irahulone/sprayer_system/v2_largim_and_katie/archives/LargimZhuta_Capstone.pdf

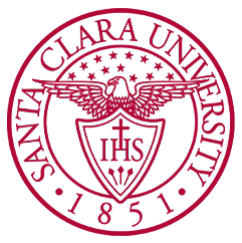
[picture p1: figure]

School Of Engineering
Mechanical Engineering Department

Date: Jun 03, 2024

I HEREBY RECOMMEND THAT THE CAPSTONE PREPARED UNDER MY SUPERVISION BY

Largim Zhuta

ENTITLED

Variable Rate Adaptive Sprayer System

BE ACCEPTED IN PARTIAL FULFILLMENT OF THE REQUIREMENTS FOR THE DEGREE

OF

MASTER OF SCIENCE IN MECHANICAL ENGINEERING IN MECHANICAL ENGINEERING DEPARTMENT

Variable Rate Adaptive Sprayer System

Capstone submitted in partial fulfillment of the requirements for the degree of

Master of Science in Mechanical Engineering

Largim Zhuta

Master Of Science In Mechanical Engineering in the School of Engineering at
Santa Clara University, Jun 2024

Santa Clara, California

Acknowledgments

I would like to express deep gratitude to my advisors and supervisors, Dr. Christopher Kitts & Dr. Manoj Sharma. They’re guidance, wisdom, and motivation to explore, discover, and engineer what is yet to be was inspiring. It was a genuine privilege and pleasure of mine to have had the opportunity to work under them and their guidance.
This marks six years that I have attended Santa Clara University. I would especially like to acknowledge all the professors I have had throughout my time here, especially Dr. Hohyun Lee, who has played a tremendous role in my academic and personal journey.
I am forever grateful to my family; They have sacrificed so much for me to have the opportunities I have had; The success I have achieved is not solely mine, but rather it is ours, collectively.
Lastly, but certainly not least, my close friends. I thank you for the companionship you have all shown me. The support you openly gave when the responsibilities I carried felt too heavy to bear will never be forgotten.
Largim Zhuta

Santa Clara University
June 15th, 2024

iii

Dedicated To,

My Family, Friends, Mentors and loved ones who have been in my corner through every step of the way.

iv

Abstract

The current labour and resource shortage is driving the agriculture industry towards adopting more humane, sustainable and efficient means of production. Robotics and automation is one of the solutions to address those challenges. Precision spraying, in particular, is a technique that relies on a precise targeted metered delivery of a desired fluid. In this paper we have designed a sprayer system as a module for our in-house modular rover that can administer a fluid in a controlled manner. It offers a discrete left and right independent spray control, each withing the rage of 120 - 400 L/h. Tests conducted in the field shows the performance within 0.1 - 4.8 % of the commanded value. Furthermore, we layout the framework for a high level sprayer-rover interface controller to intelligently adapt and command the desired flow rates
Keywords: Variable Rate Sprayer, Precision Spraying, Precision Agriculture

v

## Contents

Acknowledgments | iii
Abstract | v
Contents | v
List of Figures | vi
List of Tables | vii
1 Introduction | 1
2 System Overview | 4
3 Control and Validation | 8
4 Conclusion & Future Work | 17
A Appendix | 20

vi

## List of Figures

2.1 AgBot Rover and Sprayer System in the Field | 5
2.2 Sprayer system overview | 5
2.3 Sprayer System Plumbing and Instrumentation Diagram | 6
2.4 Sprayer and the rover system integration | 7
3.1 Control Block diagram representation of Sprayer System | 9
3.2 Sprayer system left-bank open loop response at different valve positions. . . 10 3.3 Sprayer system open-loop nozzle flow rate left and right bank time varying response to a ramp (pump power) input at a constant valve position of 80%. 11 3.4 Step-Input response to desired flow rate inputs of 131 l/h for both left and
right bank | 13
3.5 Step-Input response to desired flow rate inputs of 360 l/h for the left bank
and 210 l/h for the right bank | 14
3.6 Step-Input response to desired flow rate inputs of 210 l/h for the left bank
and 360 l/h for the right bank | 14
3.7 Multi-zone time response | 15
A.1 | | 29
A.2 | | 30
A.3 | | 31
A.4 | | 32
A.5 | | 33
A.6 | | 34
A.7 | | 35

vii

## List of Tables

3.1 Zone-level flow rates (L/h) | 16

viii

## Chapter 1

## Introduction

Agricultural industries across the globe play vital roles when it comes to the nourishment and survival of humankind. Feeding an ever-growing global population places everincreasing demands on an already stressed industry: one affected by labor shortages, climate change, human labor rights concerns, stricter food safety regulations, and a desire for more sustainable farming practices (reducing food waste) [1]. The continually expanding application of robotics and automation technologies within the agricultural sector has created a viable solution to the aforementioned challenges; the subsequent practice is referred to as precision agriculture. Robotics and automation technologies integration within agriculture can lead to more efficient, cost-effective, sustainable, and humane farming practices [2].
The application of pesticides, herbicides, fungicides, and/or other “-cides” is a significant process in agriculture pertaining to the management of pests, diseases, and weeds, allowing for increased yields. Efficient application of the aforementioned agrochemicals increases yield, but can cause environmental risks in the event of over application or double coverage of a given region. Additionally, over application can pose health risks to humans as well [3]. Over application incurs greater costs on the farmers as well. Precision spraying is one domain within precision agriculture which is adopting automation technologies to improve efficacy and minimize waste via various precision spraying techniques and methodologies.
Variable rate automated sprayer systems consist of two major processes: automated 1

1.1 Ethical Implications and Considerations | 2

vision-based weed detection and automated targeted-spraying; it is an area of current research and development efforts [4], [5], [6], [7]. The aforementioned techniques have been implemented in large-scale productions fields, displaying the viability of the technology [8]. Commercial systems, such as the One Smart Spray from Bosch [9] employs real-time weed detection via high-resolution cameras to identify weeds; it then applies herbicide in the locations needed, reducing costs for the growers while also reducing the amount of herbicide needed.
Different vehicle types exist within the realm of precision spraying: unmanned aerial vehicles (UAV) [10], ground-level fluid lines, and self-propelled ground vehicles. The scope of the presented work is to create a modular precision sprayer system which is able to be integrated to an existing rover, developed by Santa Clara University’s Robotics Systems Laboratory; the rover is referred to as the Agbot [11]. The motivation behind the creation of the sprayer is system is to elevate the functional capabilities of the Agbot and similar robotic/rover platforms which serve as a support system for various precision agricultural operations. [12].

### 1.1 Ethical Implications and Considerations

Robots have shown their utility in agricultural field operations [13]. Capable of operating in environments that are deemed harsh and difficult for humans, as well as being able to meet the demands of strenuous labor requirements and challenging work patterns, robots and robotic devices are capable of supplanting human laborers. The pace of the transition will likely be a gradual process, creating a transition phase in which humans and robots will co-exist in the field operations [14]. Another considerable challenge the agriculture industry faces is a significant labor shortage; the consequences of which includes crops going unharvested, leading to food waste, and higher labor costs [15]. Utilizing robotic and automation technology can supplement and provide the existing labor and its capabilities, but with added efficiency at a more cost-effective rate. Despite all the benefits robotics and automation is poised to provide, we acknowledge that there are some ethical considerations. Like most transitions and adoptions of new technologies, there are positive and

1.1 Ethical Implications and Considerations | 3

negative impacts. Supplanting human labors with robotics, especially in precision spraying application, reduces humans’ exposure to spraying chemicals, decreasing the health risks of the farmers. Additionally, robotics and automation are able to perform repetitive, heavelabor tasks, alleviating human laborers from the chore. The tradeoff is that human laborers will be displaced.

## Chapter 2

## System Overview

The system overview is split in four different subsection. The first three subsections provides an overview of the mechanical, electrical and software architecture of the sprayer module fol- lowed by a description on the specifics of how the sprayer module is integrated within the rover system in mechanical, electrical and software sense. Figure A.7

### 2.1 Mechanical Subsystem

The mechanical sub-system is comprised of two sub-assemblies: the frame structure and the plumbing. The frame structure serves as the backbone of the sprayer system. It is assembled from aluminum T-slotted rails. Virtually all of the subsystems are mounted onto the frame structure The plumbing sub system includes (1) Fluid Reservoir, (2) positivedisplacement pumps, silicone vacuum seal tubing, and (4) modular Nozzle Units (NUs) as shown in Figure 1.
The NUs are comprised of (3) key components: a servo valve, a flow sensor, and a nozzle. NU 1, NU 2, and the Left Pump constitute the left bank of the Sprayer System. NU 3, NU 4, and the Right Pump make up the right bank. Each bank operates independently of the other: they only share the same reservoir tank. This is shown in plumbing schematic.

4

2.2 Electrical Subsystem | 5

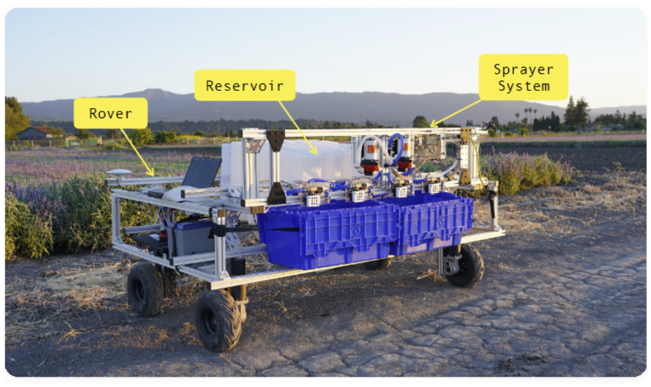
[picture p2: figure]

Figure 2.1 – AgBot Rover and Sprayer System in the Field

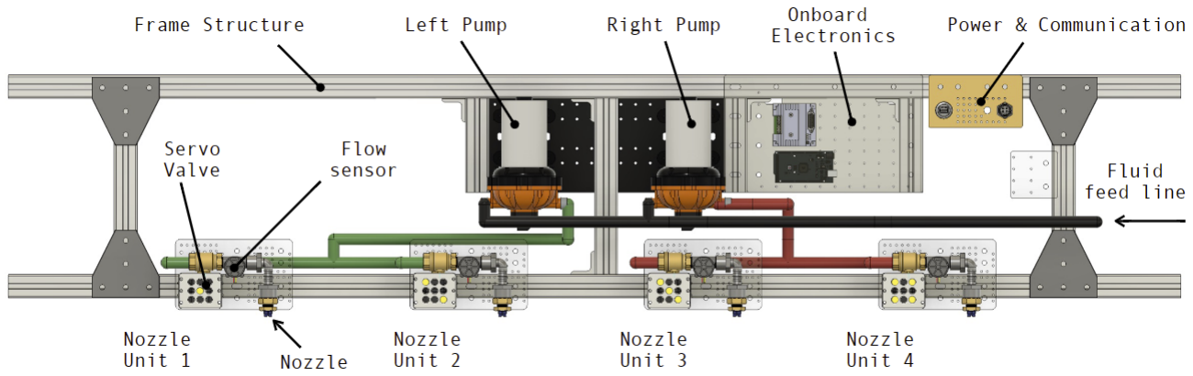
[picture p3: figure]

Figure 2.2 – Sprayer system overview.

### 2.2 Electrical Subsystem

The key electrical subsystem comprises of the pump, servo controlled valve, and flow rate sensor. The two pumps are controlled by a (RoboteQ) motor controller. An Arduino Mega 2560 is the micro-controller of choice which controls the respective pump power, servovalve, and receives the instantaneous flow rate information from all four nozzle units.
An onboard computer (Jetson Nano) is dedicated to allow the information exchange between the sprayer system and the rover system. The entire sprayer system is designed to operate at 12 VDC which is provided by the rover.

2.3 Software Subsystem | 6

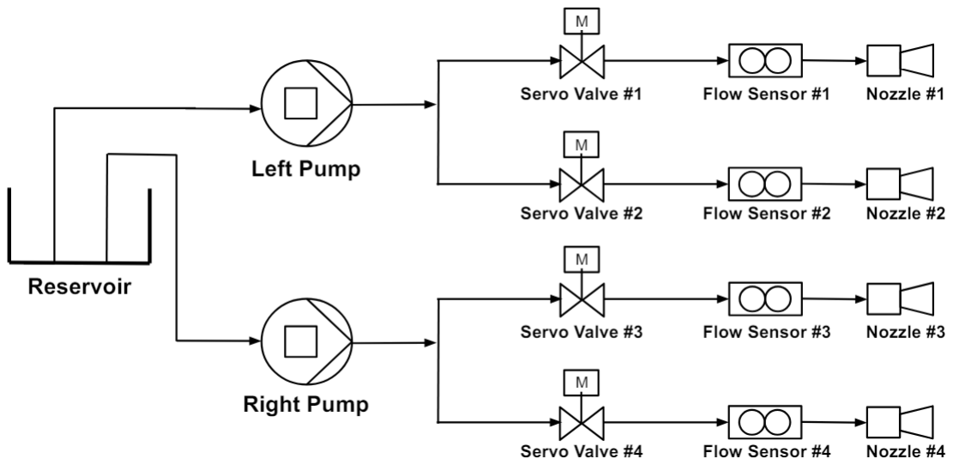
[picture p4: figure]

Figure 2.3 – Sprayer System Plumbing and Instrumentation Diagram

### 2.3 Software Subsystem

Three functional systems exist within the software subsystem: data acquisition, data display, and the controller. Real-time flow rate data and pump power is recorded for each flow sensor and each pump. It is stored in ROS 1 bags via an additional Arduino Mega 2560. The aforementioned real-time data is displayed in a serial monitor within the Arduino IDE. An error-based Proportional Integral (PI) controller with a feed-forward term is implemented for the sprayer system; desired flow rate data and measured flow rate data is used to calculate the error.

### 2.4 Sprayer-Rover Integration

In a bus and payload analogy, the sprayer system is the payload which relies on the rover (the bus) to receive the necessary support needed for the mission. Both, the rover and the sprayer system are constructed using a standard size T-slotted aluminium bar. This allows for a convenient mechanical integration using off-the-shelf brackets. The sprayer receives the electrical power from the rover. The rover system uses the Robot Operating System (ROS) middleware as the main control framework [11]. Figure 2.4 shows the overall sprayer-rover integrated system. The sprayer controller has access to the position sensors, speed, vision system and other onboard data to compute desired flow rate information.

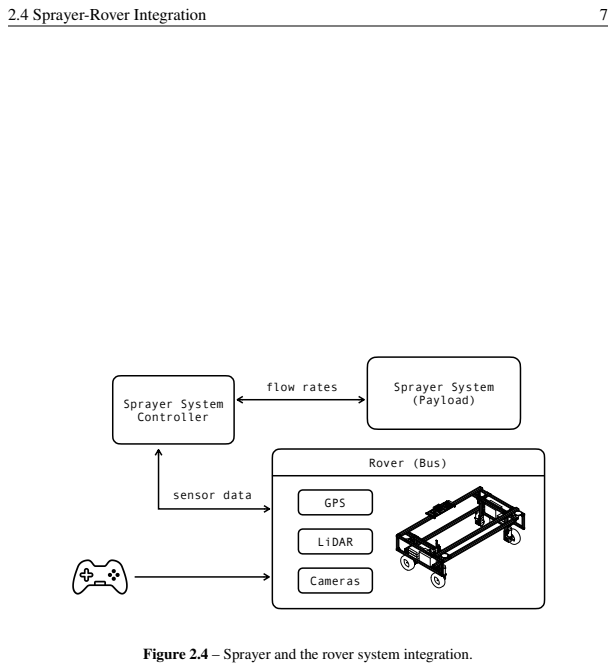
[picture p5: page 15]
2.4 Sprayer-Rover Integration; GPS; Cameras; Rover (Bus); Sprayer System; (Payload); Controller; LiDAR; flow rates; sensor data

Figure 2.4 – Sprayer and the rover system integration.

## Chapter 3

## Control and Validation

While Proportional-Integral-Derivative (PID) control methodology is a very established and robust control scheme, we opted for a Proportional-Integral (PI) Control with a mapping function. The mapping function serves as a pseudo feed-forward term which incorporates information regarding the open-loop behavior of the system.

### 3.1 Control System Design

The control system design is a Proportional-Integral (PI) controller with the addition of a mapping function. The controller scheme inputs are desired flow rates for the left and right bank, ¯ql and ¯qr

, respectively. Separate and unique mapping functions Ml and Mr are used to convert the desired flow rates into a pump powers for each bank. The desired flow rate signals are then summed with the measured flow rates, ql and qr creating resultant error signals, el and er for the two banks. The error signal is then fed into a Proportional-Integral controller. The output of the left and right bank controllers yield a pump power value, pl and pr

.The pump power values are then summed at each summing junction and fed into the their respective pumps. The pumps then produce a flow rate, which is fed through the servo valves, flow sensor, and nozzle; this ultimately outputs the measured flow rate.

8

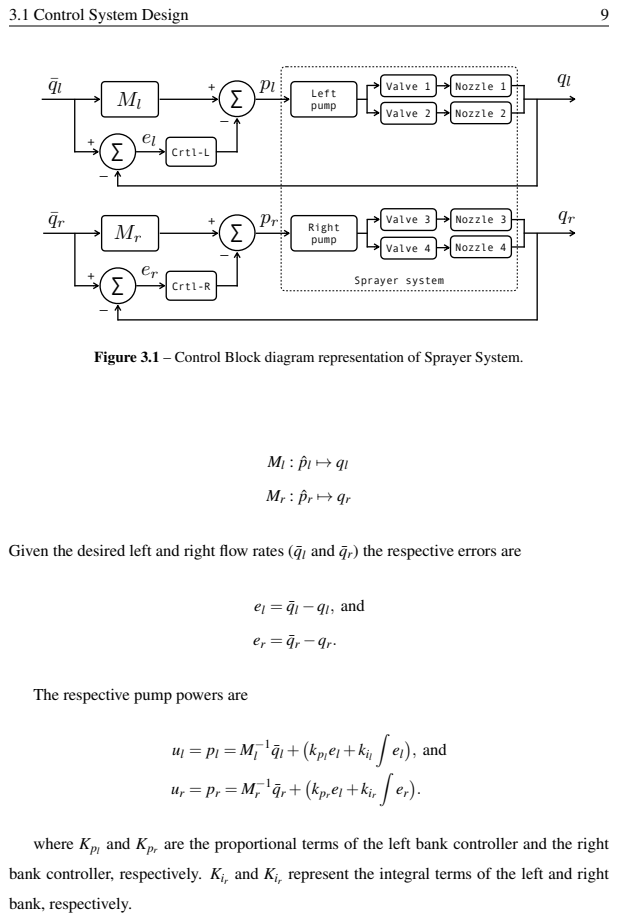
[picture p6: page 17]
3.1 Control System Design; Left; pump; Nozzle 1; Nozzle 2; Crtl-L; Right; Nozzle 3; Nozzle 4; Crtl-R; Sprayer system; Valve 1; Valve 2; Valve 3; Valve 4; : ˆpl; : ˆpr; , and; kpl; el +kil;  , and;  kpr; el +kir; and Kpr; and Kir

Figure 3.1 – Control Block diagram representation of Sprayer System.

Given the desired left and right flow rates ( ¯ql and ¯qr) the respective errors are

The respective pump powers are

where Kpl
bank controller, respectively. Kir
bank, respectively.

are the proportional terms of the left bank controller and the right

represent the integral terms of the left and right

3.1 Control System Design | 10

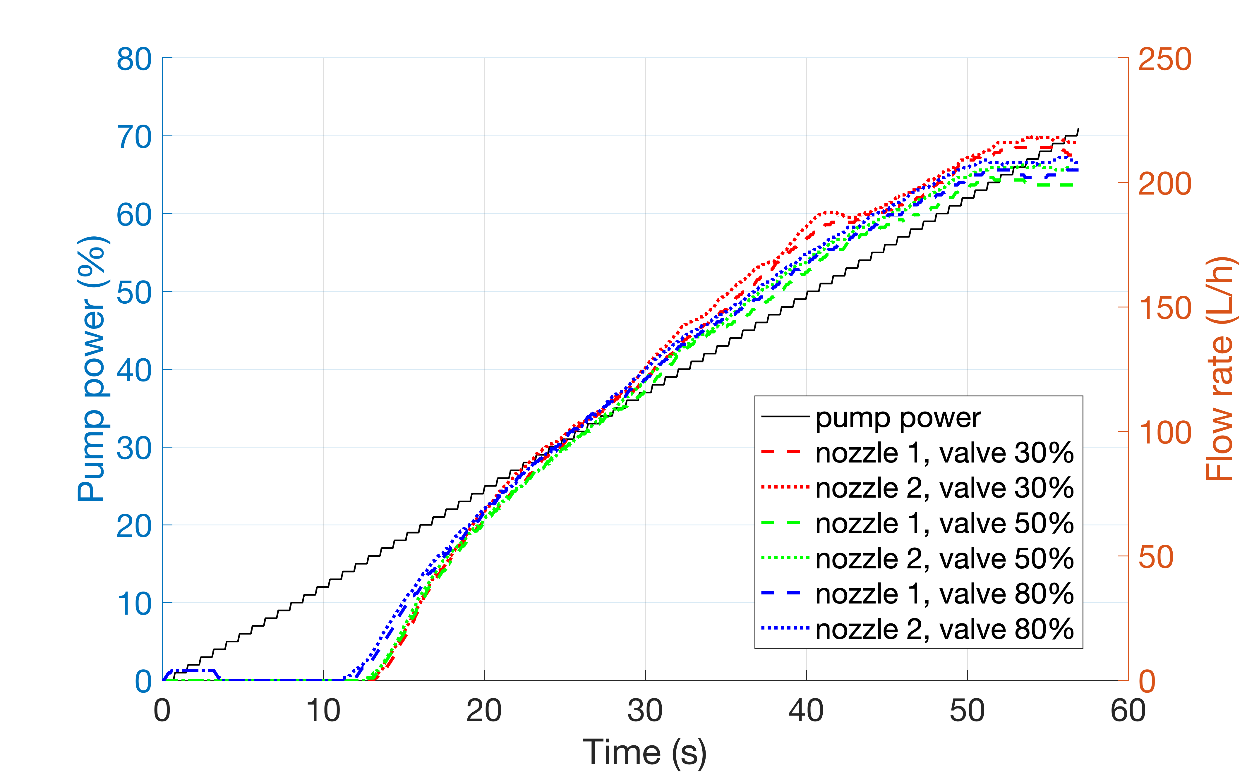
[picture p7: figure]

Figure 3.2 – Sprayer system left-bank open loop response at different valve positions.

### 3.1.1 Mapping Function

The relationship between valve positions, pump power, and flow rate was investigated. An open-loop system test was ran for a ramp-input of pump powers ranging from 0% to 70%. Three of these open-loop trials were ran, each at a constant valve position. In Figure 3.2, the open-loop response of the Left Bank can be seen. It is discovered that for a given pump power, the valve position has virtually no effect on the flow rate of the system – barring the valve is completely closed. Pump power is the only variable that affected the flow rate. Utilizing the open-loop characteristics of the system, distinct mapping functions are created for each bank, correlating pump power to a specific flow rate. The plot was generated by using a ramp-input at valve positions of 80% open. Figure 3.3 displays the open loop behavior of each bank. It can be seen that despite being the same pump, the open-loop characteristics of each of the banks differs slightly; for the same pump power, the Right Bank is able to dispense for fluid than the Left Bank. This could be due to differing lengths of tubing needing to be used or that the Right Bank pump was new compared to the Left Bank pump.

3.1 Control System Design | 11

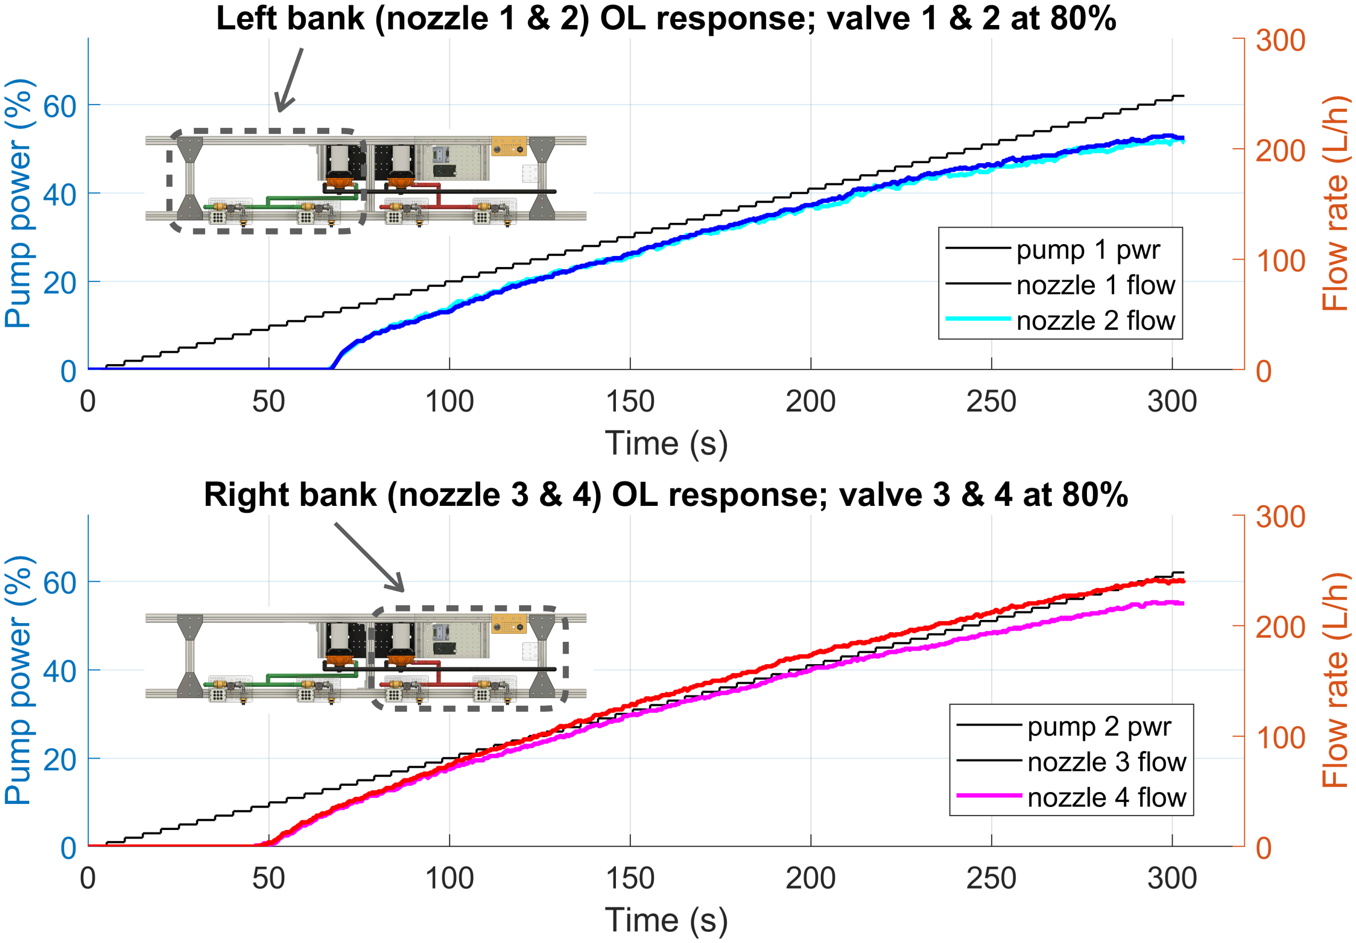
[picture p8: figure]

Figure 3.3 – Sprayer system open-loop nozzle flow rate left and right bank time varying response to a ramp (pump power) input at a constant valve position of 80%.

3.2 Testing and Results | 12

### 3.2 Testing and Results

The sprayer is a closed loop system, delivering a desired flow rate using an error-based controller. The performance of the system is highly dependent on the accuracy of each flow sensor. System performance verification was performed concurrently with system performance testing.
System performance testing was solely based on the collecting flow sensor data given an array of desired inputs. The verification portion involved collecting the dispensed water via collection bins and noting the total time elapsed during the trial. Average flow rates for each bank were then calculated by dividing the total volume of water collected in the bins by the total time of the trial. Note that this method of verification is prone to human error in measurement and reaction time, resolution error in the analog measuring tools, evaporation due to wind, etc.
The testing occurred on a nearby farm in an environment that would likely resemble the rover and sprayer system’s natural area of operation: one with external factors such as wind, dust, and uneven, rocky terrain. The testing occurred while the rover was in motion at a speed within the range of 0.2m/s to 0.4m/s. In order to determine the performance of the system, time-response plots are captured for arbitrary step-inputs.

### 3.2.1 Left Bank Flow: 131 L/h & Right Bank Flow: 131 L/h

In Fig. 3.4, the desired flow is set to 131 L/h for both banks. It takes the left and right bank approximately 8.5 seconds to settle given a 15% error band. The reason behind the relatively large error band is because the system is not able to fully settle below a 15% error due to limitations in the sensors’ resolution and computation.
The recorded flow rate data appears to take on discrete values. In the steady state region of Fig.3.4, the recorded data takes on one of the following values: 113 L/h , 122 L/h, 131 L/h, a 140 L/h. This indicates that the resolution of the sensor is roughly 9L/h per bit. Given this finding, performing Root Mean Squared (RMS) calculations on the entirety of data provides greater insight over the steady state behavior.
The RMS value for the left bank in Fig.3.4 is 125.3 L/h, and the RMS value for the right

3.2 Testing and Results | 13

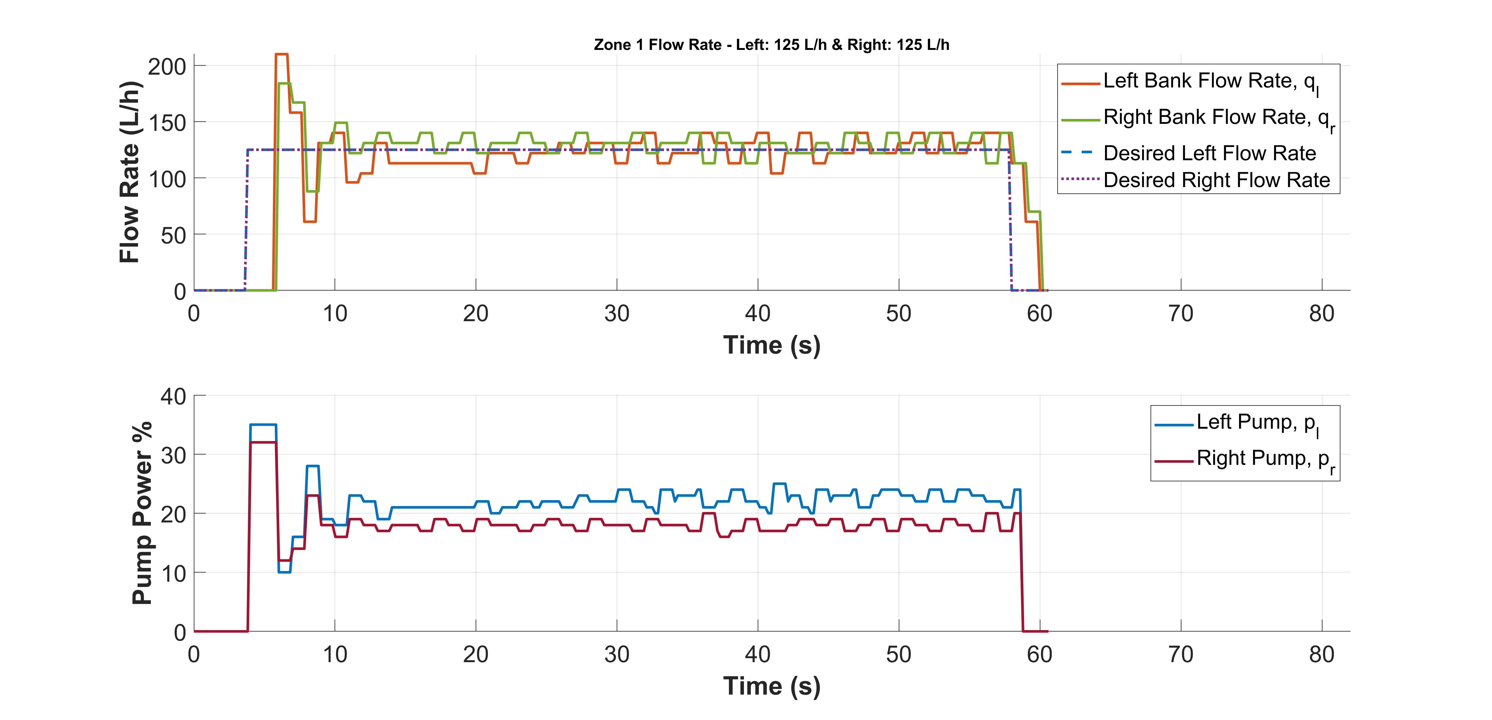
[picture p9: figure]

Figure 3.4 – Step-Input response to desired flow rate inputs of 131 l/h for both left and right bank.

bank is 130.8 L/h. The RMS value is compared against the desired flow rate of 131L/h for both banks; it equates to an error of 4.8% and 0.1% for the left and right bank, respectively. From the verification test, the calculated flow rates are determined to be 133.4 L/h and 131.7 L/h for the left and right banks, respectively. This amounts to an error of 1.8% and 0.5% between the desired flow rates and averaged flow rates of the system.

### 3.2.2 Left Bank Flow: 360 L/h & Right Bank Flow: 210 L/h

In Fig.3.5, the settling time for the system is shorter, and the error band is smaller; for a 10% error band, the settling time is approximately 2.5 seconds for both banks. The RMS values are 353.4L/h and 211.0L/h for the left and right bank, respectively. It equates to errors of 1.8% and −0.4%.
For the verification test performed in Fig. 3.5, the desired flow rates are 360L/h and 210L/h, respectively. The average flow rates are calculated to be 356.0L/h and 211.8L/h for the left and right bank respectively: yielding absolute errors of 1.1% and 0.8%

3.2 Testing and Results | 14

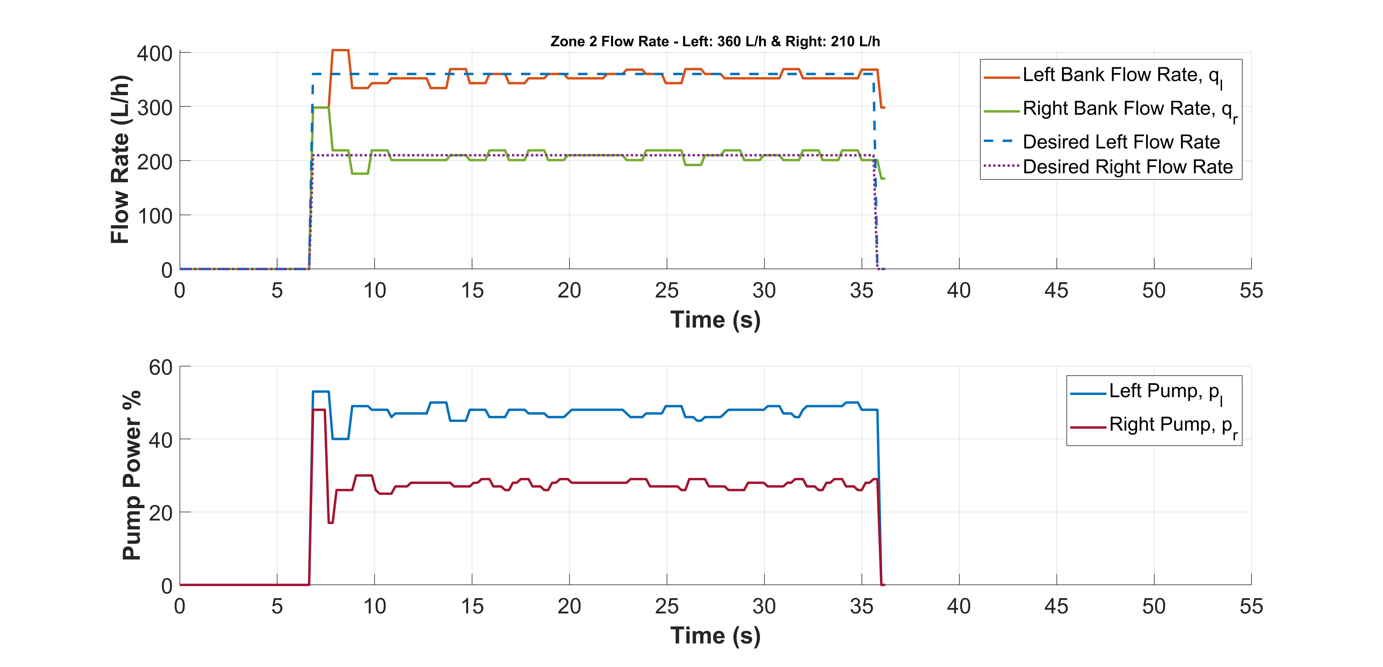
[picture p10: figure]

Figure 3.5 – Step-Input response to desired flow rate inputs of 360 l/h for the left bank and 210 l/h for the right bank.

### 3.2.3 Left Bank Flow: 210 L/h & Right Bank Flow: 360 L/h

In Fig.3.6, a similar result can be seen when the desired flow rates for the left and right banks are swapped with the other. The 10% settling time is also approximately 2.5 seconds for both banks. The RMS values are 208.0L/h and 353.4L/h for the left and right bank, respectively. This yields errors of 0.9% for the left bank and 1.8% for right bank.

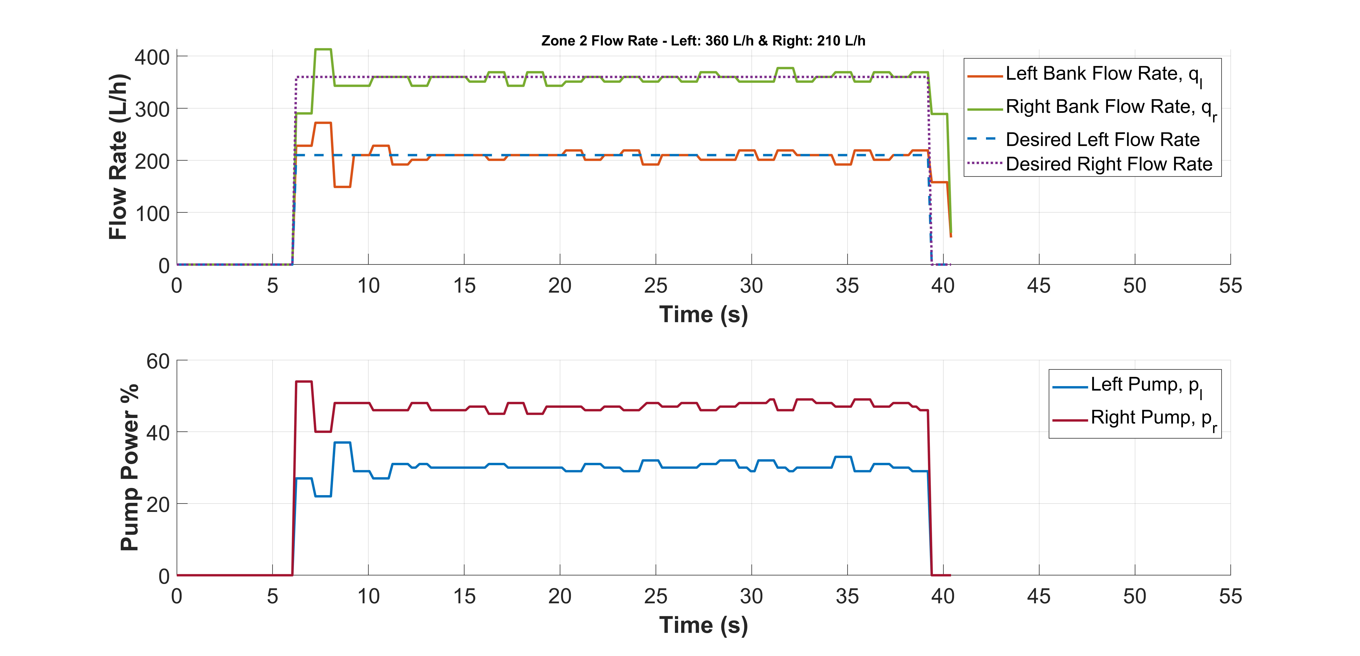
[picture p11: figure]

Figure 3.6 – Step-Input response to desired flow rate inputs of 210 l/h for the left bank and 360 l/h for the right bank.

3.2 Testing and Results | 15

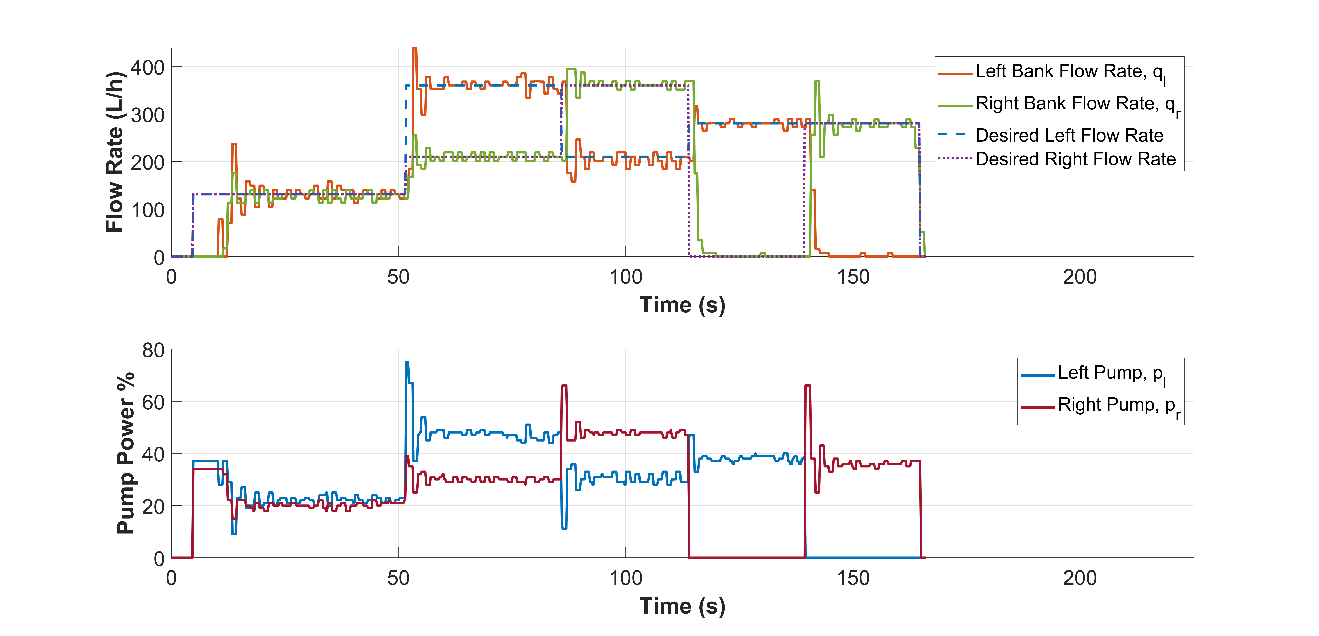
[picture p12: figure]

Figure 3.7 – Multi-zone time response.

In Fig. 3.6 the desired flow rates for the left and right bank are 210L/h and 360L/h, respectively. The average flow rates for the left and right bank were 217.5L/h and 352.3L/h, amounting to errors of 3.6% and 2.1%.

### 3.2.4 Continuous Variable Flow Rate Test Run

Figure 3.7 shows a performance test for a multi-zone trial. Five arbitrary zones were created, each with different desired flow rates. The multi-zone trial was performed while the rover was moving at speeds between 0.2m/s and 0.4m/s.The zones were advanced via button toggling through the main rover controller; this displays the potential ability to control the sprayer through an outer, rover control loop which could include GPS data, LIDAR, or vision data as shown in Fig. 2.4
The performance of the multi-zone run is consistent with what was seen in the step-input responses. The desired flow rate, sensor reading, and actual measured volume/calculated flow rates are tabulated in 3.1. In terms of system performance, the settling time between zone transitions is between 2 to 3 seconds; it remains consistent with the individual step inputs. One notable exception can be seen in the plot during the initial power up; the reason behind the larger than expected settling time of the first zone is due to the pumps needing time to prime the system. Left at rest for a sufficient amount of time, the water

3.2 Testing and Results | 16

Table 3.1 – Zone-level flow rates (L/h)
Zone | Left-bank flow | Right-bank flow
Desired Flow | Sensor | Actual Flow | Desired Flow | Sensor | Actual Flow
1 2 3 | 131 360.0 210.0 | 125.3 353.4 208.0 | 133.4 356.0 217.5 | 131.0 210.0 360.0 | 130.8 211.0 353.4 | 131.7 211.8 352.3

drains downward and out of pumps, thus causing a larger initial settling time.
The results from the system performance tests indicate that the system is able to administer the desired flow rate within a 4.8% RMS error margin. (i.e. RMS flow sensor reading compared to the desired flow rate). The system performance verification shows that the administered flow rate is accurate to within a 3.6% error margin (i.e. the physical amount of water collected over a finite time compared to the desired flow rate)

## Chapter 4

## Conclusion & Future Work

### 4.1 Conclusion

In this paper We have designed and constructed a modular sprayer attachment for the existing Agbot Rover which provides the necessary infrastructure for the mission. The sprayer system’s closed-loop proportional-integral controller with a mapping function has been shown to be capable of administering the desired flow rate within an error margin between 0.1% and 4.8%. Furthermore it has displayed the ability to toggle between various different flow rates within a 2 − 3 second settling time between each transition. Lastly, a framework has been created between the sprayer and rover which will allow for the exchange of information between the two. The main purpose of the framework is to develop prescription-based controller.

### 4.2 Future Work

The next logical step of the Sprayer System and Agbot Rover evolution would be to incorporate GPS data from the Agbot Rover to control the desired flow rate based on the location of the Rover in field. Further future work could be focused on incorporating the Rover’s velocity in the sprayer system controller in order to provide a flow rate metric of volume sprayed per area; this is the industry standard with regards to spraying operations within the agriculture industry.
17

## List of References

[1] J. P. Vasconez, G. A. Kantor, and F. A. Auat Cheein, “Human–robot interaction in agriculture: A survey and current challenges,” Biosystems Engineering, vol. 179, pp. 35 – 48, 2019. [Online]. Available: http://www.sciencedirect.com/science/article/pii/S1537511017309625 (http://www.sciencedirect.com/science/article/pii/S1537511017309625)
[2] S. S. H. Hajjaj and K. S. M. Sahari, “Review of agriculture robotics: Practicality and feasibility,” in 2016 IEEE International Symposium on Robotics and Intelligent Sensors (IRIS), 2016, pp. 194–198.
[3] F. Ahmad and M. Sultan, “Advancements of spraying technology in agriculture,” in Technology in Agriculture, 2021, pp. 33–43.
[4] Y. Guan, D. Chen, K. He, Y. Liu, and L. Li, “Review on research and application of variable rate spray in agriculture,” in 2015 IEEE 10th Conference on Industrial Electronics and Applications (ICIEA), 2015, pp. 1575–1580.
[5] R. Berenstein and Y. Edan, “Automatic adjustable spraying device for site-specific agricultural application,” IEEE Transactions on Automation Science and Engineering, vol. 15, no. 2, pp. 641–650, 2018.
[6] R. Aravind, M. Daman, and B. S. Kariyappa, “Design and development of automatic weed detection and smart herbicide sprayer robot,” in 2015 IEEE Recent Advances in Intelligent Computational Systems (RAICS), 2015, pp. 257–261.
[7] A. Khan, F. Nasir, M. Tufail, M. Haris, M. T. Khan, and Z. Dong, “Design and implementation of model predictive control (mpc) based pressure regulation system for

18

List of References | 19

a precision agricultural sprayer,” in 2023 International Conference on Robotics and Automation in Industry (ICRAI), 2023, pp. 1–6.

[8] G. H. do Nascimento, F. Weber, G. Almeida, F. Terra, and P. L. J. Drews, “A perception system for an autonomous pesticide boom sprayer,” in 2019 Latin American Robotics Symposium (LARS), 2019 Brazilian Symposium on Robotics (SBR) and 2019 Workshop on Robotics in Education (WRE), 2019, pp. 86–91.
[9] B. Blakely. (2023) One smart spray. [Online]. Available: https://www.businesswire.com/news/home/20230912991567/en/ (https://www.businesswire.com/news/home/20230912991567/en/)
[10] Y. Guo, C. Liu, and M. Coombes, “Spraying coverage path planning for agriculture unmanned aerial vehicles,” in 2021 26th International Conference on Automation and Computing (ICAC), 2021, pp. 1–6.
[11] Modular and Reconfigurable Multiple Drive-Unit Based Rover - Design and Control, ser. ASME International Mechanical Engineering Congress and Exposition, vol. Volume 2: Advanced Design and Information Technologies, 10 2023. [Online]. Available: https://doi.org/10.1115/IMECE2023-112155
[12] S. J. LeVoir, P. A. Farley, T. Sun, and C. Xu, “High-accuracy adaptive low-cost location sensing subsystems for autonomous rover in precision agriculture,” IEEE Open Journal of Industry Applications, vol. 1, pp. 74–94, 2020.
[13] R. Bogue, “Robots poised to revolutionise agriculture,” vol. 43, no. 5, 2016.
[14] F. A. Cheein, D. Herrera, J. Gimenez, R. Carelli, M. Torres-Torriti, J. R. Rosell-Polo,
A. Escolà, and J. Arnó, “Human-robot interaction in precision agriculture: Sharing the workspace with service units,” in 2015 IEEE International Conference on Industrial Technology (ICIT), 2015, pp. 289–295.
[15] F. Yandun Narvaez, G. Reina, M. Torres-Torriti, G. Kantor, and F. A. Cheein, “A survey of ranging and imaging techniques for precision agriculture phenotyping,” IEEE/ASME Transactions on Mechatronics, vol. 22, no. 6, pp. 2428–2439, 2017.

## Appendix A

## Appendix

This Capstone Paper is predominantely based on a conference paper written for an ASME Conference. The Capstone paper goes into further detail regarding the controller used for the sprayer system.

A.1 Code Listings

The listings package allows you to include code listings or other formatted text with some parsing to make them more readable than simply calling \input{} on the code file.

Listing A.1 – ARDUINO Sprayer System Controller Code label ✞ | ☎

/ / Hardware − Arduino Mega 2560

i n t u_p1 = 0 ;
i n t u_p2 = 0 ;

f l o a t pump_pwr [ 2 ] = { 0 . 0 , 0 . 0 } ;
f l o a t v a l v e _ p o s [ 4 ] = { 0 . 0 , 0 . 0 , 0 . 0 , 0 . 0 } ;
f l o a t f l o w _ r a t e _ u f [ 4 ] = { 0 . 0 , 0 . 0 , 0 . 0 , 0 . 0 } ; f l o a t f l o w _ r a t e [ 4 ] = { 0 . 0 , 0 . 0 , 0 . 0 , 0 . 0 } ;
f l o a t d e s _ f l o w _ r a t e [ 4 ] = { 0 . 0 , 0 . 0 , 0 . 0 , 0 . 0 } ;

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

A.1 Code Listings | 21

i n t f l o w _ s 3 _ a r [ window_size ] ;

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

un si gned l o n g c u r r e n t T i m e ;

un si gned l o n g cloopTime ;

un si gned l o n g cloopTime2 ;

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

v oi d s e t _ v a l v e ( i n t i = 0 , i n t x = 0) {

A.1 Code Listings | 22

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

i f ( x < 0) x = 0 ;
e l s e i f ( x >= 100) x = 10 0;
i n t v = map ( x , 0 , 100 , 0 , 2 5 5 ) ;

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

i n t max_per = 6 0 ;
i f ( v a l < 0) v a l = 0 ;
e l s e i f ( v a l > max_per ) v a l = max_per ; i n t v = map ( val , 0 , 100 , 0 , 1 0 0 0 ) ;

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

i f ( ch ==2)
{
S e r i a l 3 . p r i n t ( " !G 2 " ) ;

A.1 Code Listings | 23

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

A.1 Code Listings | 24

r e t u r n a ;
}

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

r e t u r n a ;
}

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

r e t u r n a ;
}

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

r e t u r n a ;
}

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

A.1 Code Listings | 25

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

d e b u g _ d i s p ( ) ;
}

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

}

}

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

}

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

A.1 Code Listings | 27

i f ( x == 1)
{
v a l v e _ p o s [ 0 ] = y ; }
i f ( x == 2)
{
v a l v e _ p o s [ 1 ] = y ; }
i f ( x == 3)
{
v a l v e _ p o s [ 2 ] = y ; }
i f ( x == 4)
{
v a l v e _ p o s [ 3 ] = y ; }
pump_pwr [ 0 ] = z ;
pump_pwr [ 1 ] = z ;
* /

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

i f ( u_p1 > 60) u_p1= 6 0 ; i f ( u_p1 < 0) u_p1= 0 ;

i f ( u_p2 > 60) u_p2= 6 0 ; i f ( u_p2 < 0) u_p2= 0 ;

pump_pwr [ 0 ] = u_p1 ;

A.2 Conference Paper | 28

pump_pwr [ 1 ] = u_p2 ;

}

✝ | ✆

A.2 Conference Paper

The remainder of this section is intentionally left blank.

A.2 Conference Paper | 29

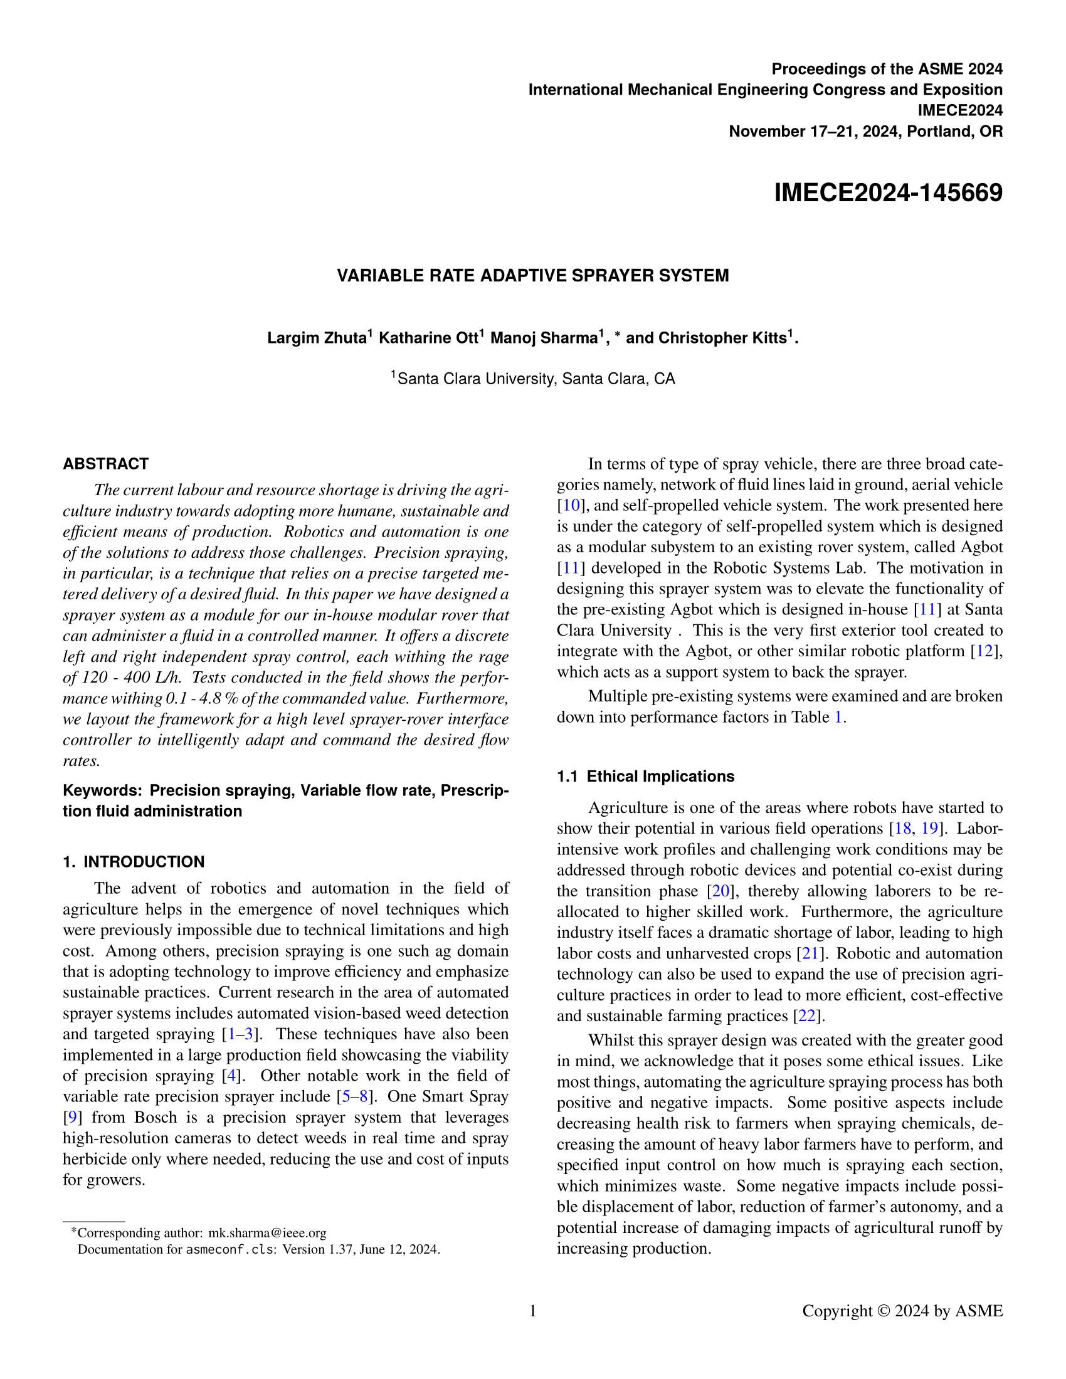
[picture p13: figure]

Figure A.1

A.2 Conference Paper | 30

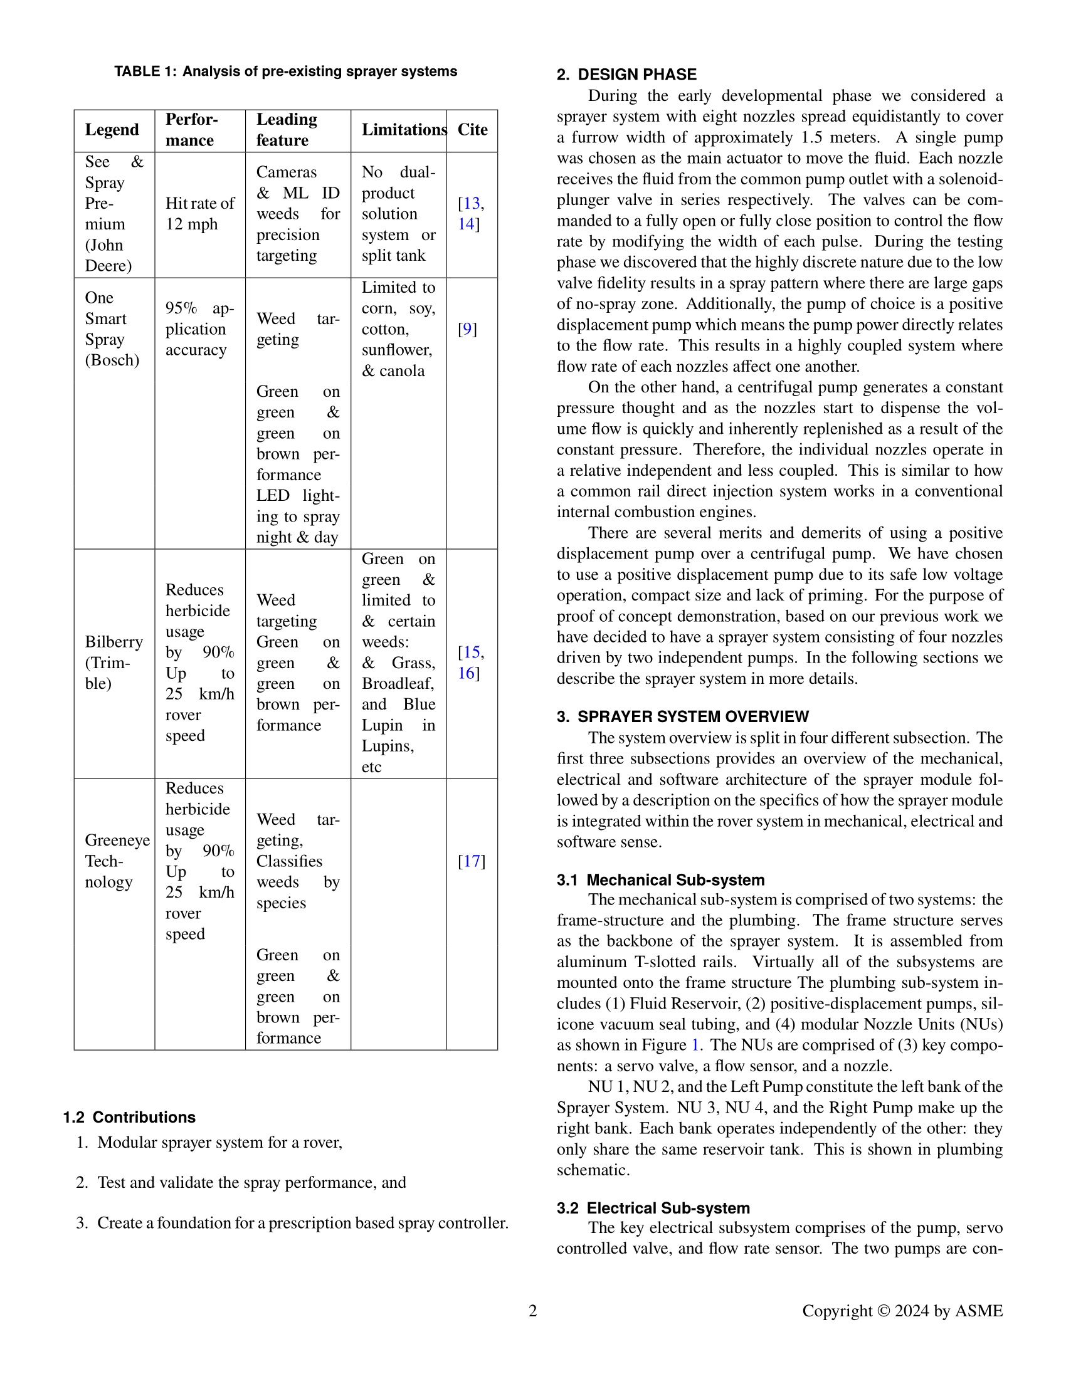
[picture p14: figure]

Figure A.2

A.2 Conference Paper | 31

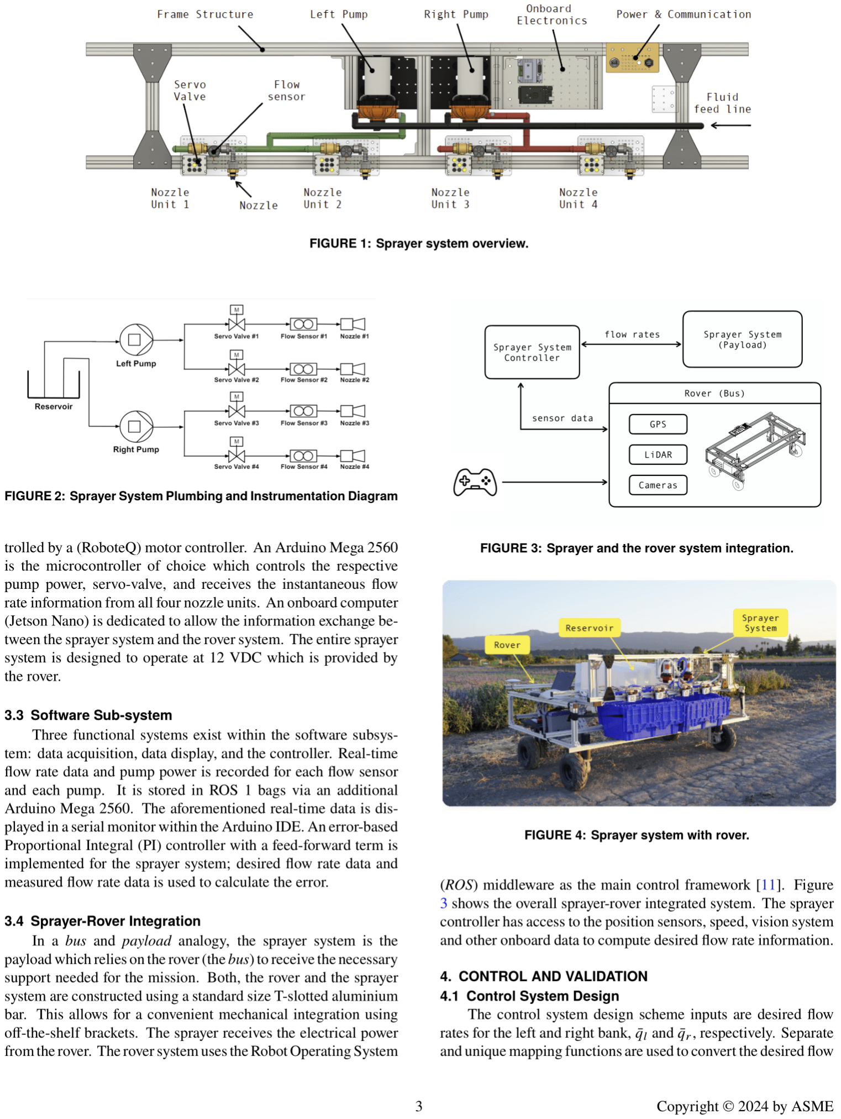
[picture p15: figure]

Figure A.3

A.2 Conference Paper | 32

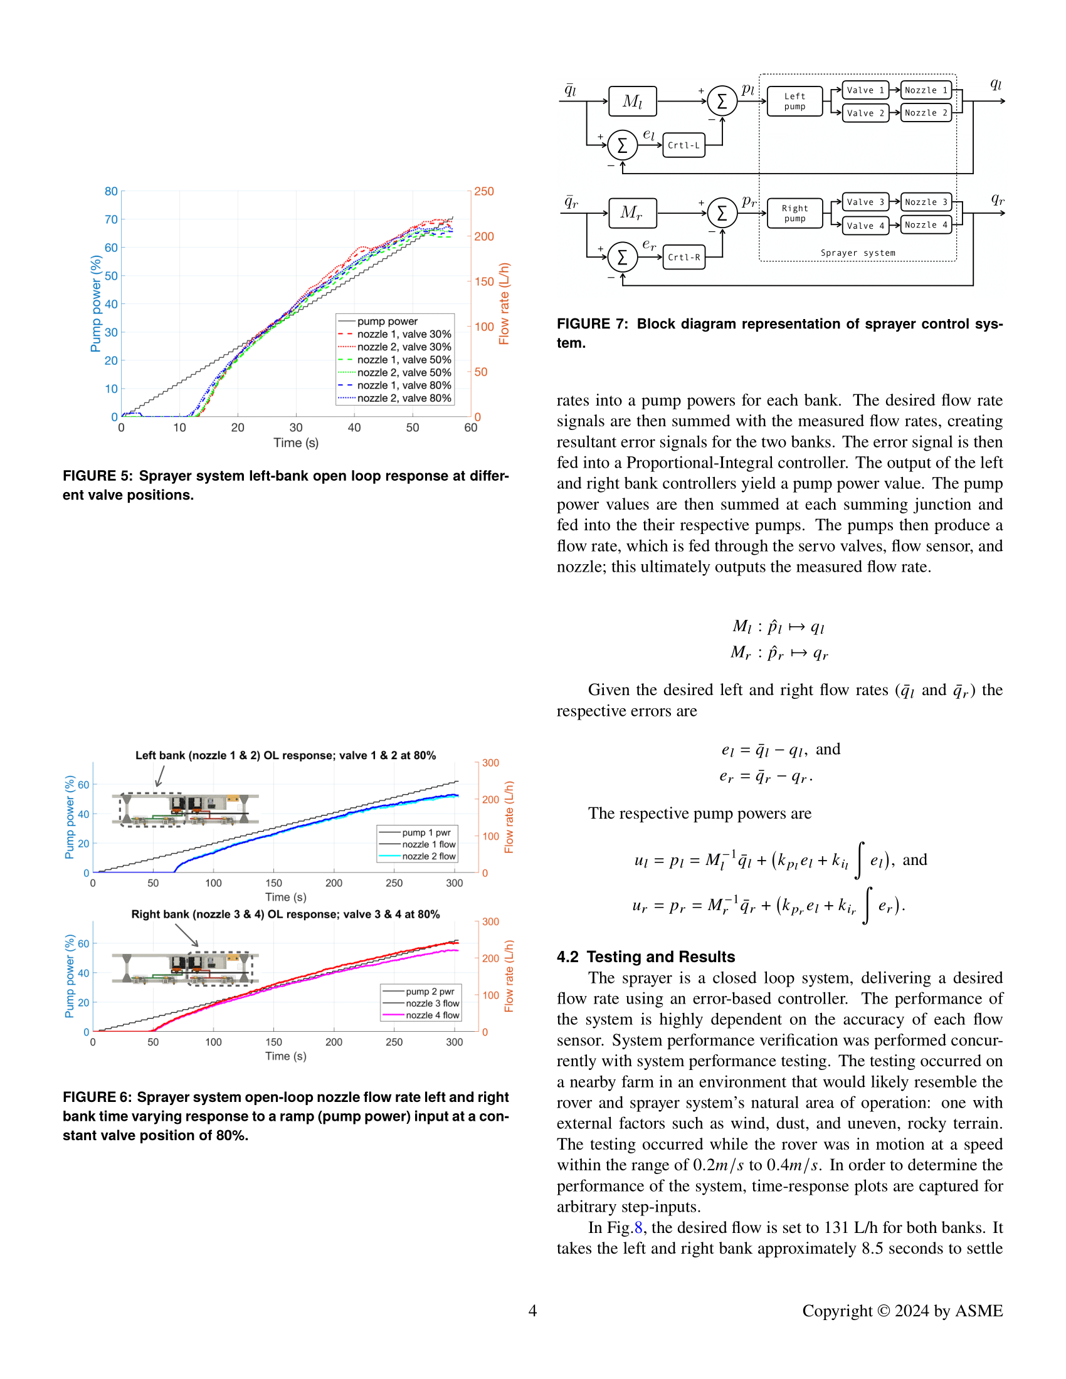
[picture p16: figure]

Figure A.4

A.2 Conference Paper | 33

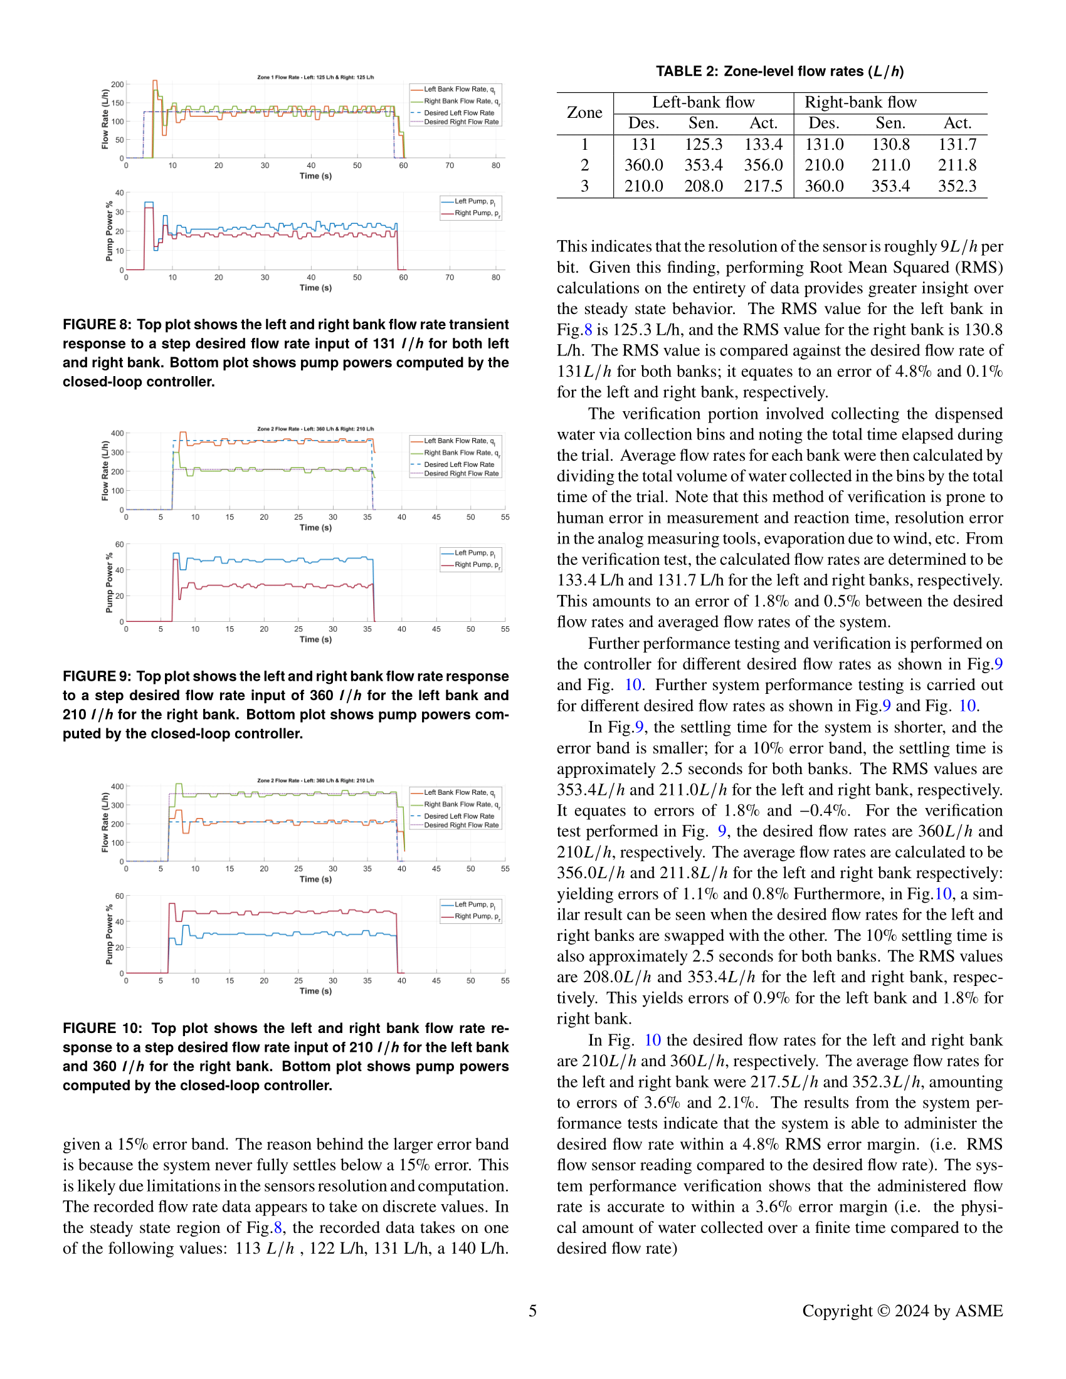
[picture p17: figure]

Figure A.5

A.2 Conference Paper | 34

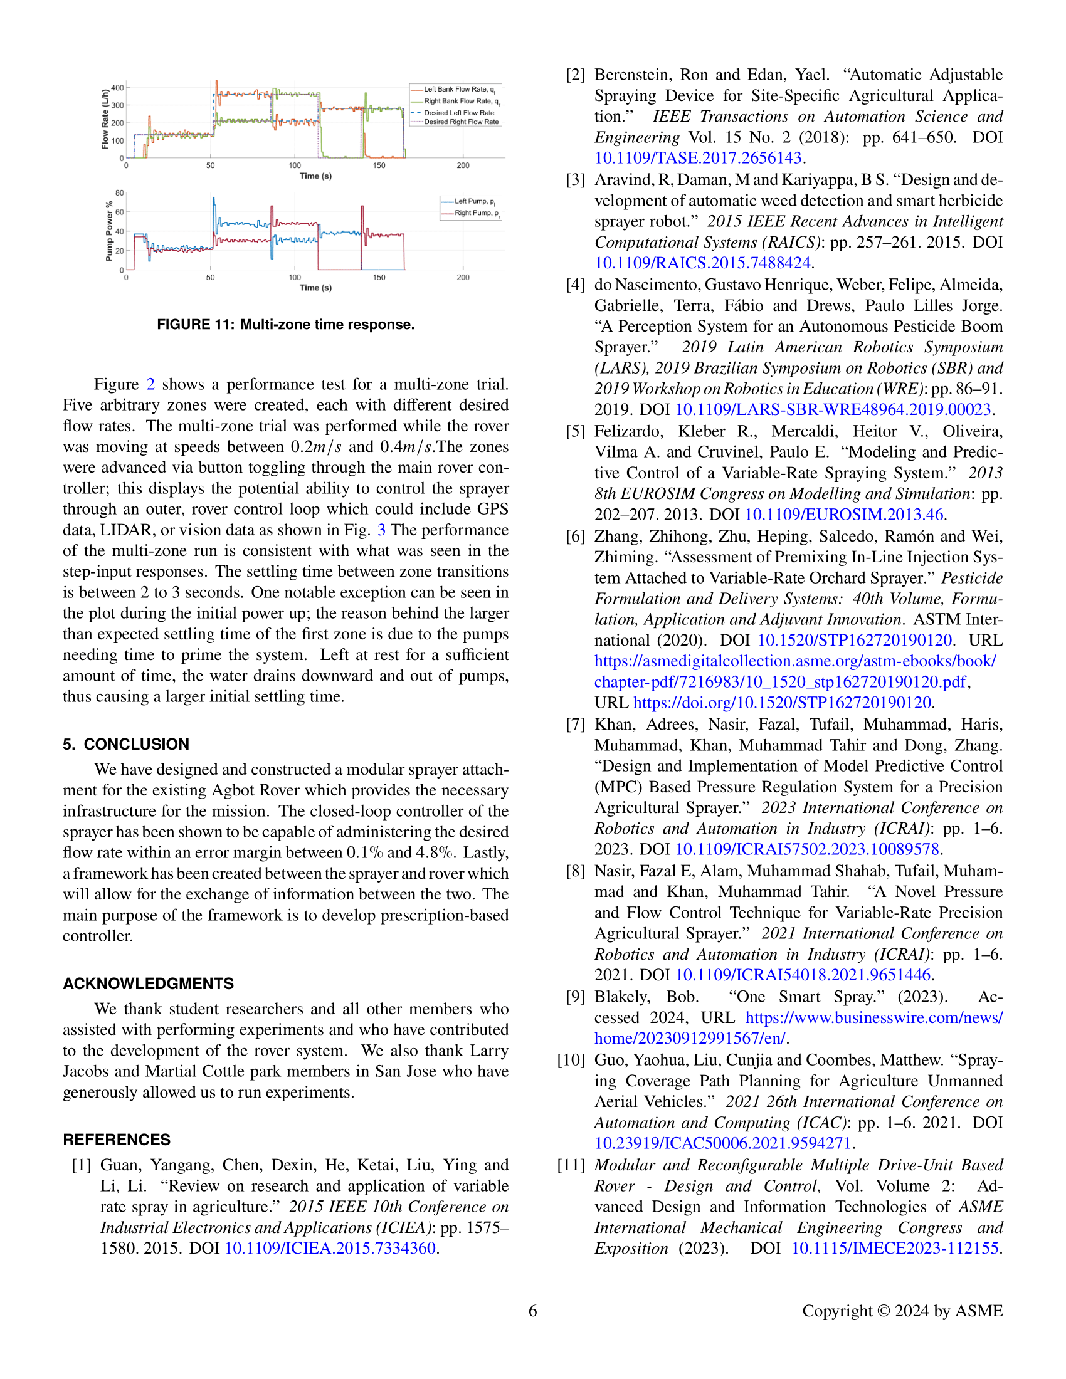
[picture p18: figure]

Figure A.6

A.2 Conference Paper | 35

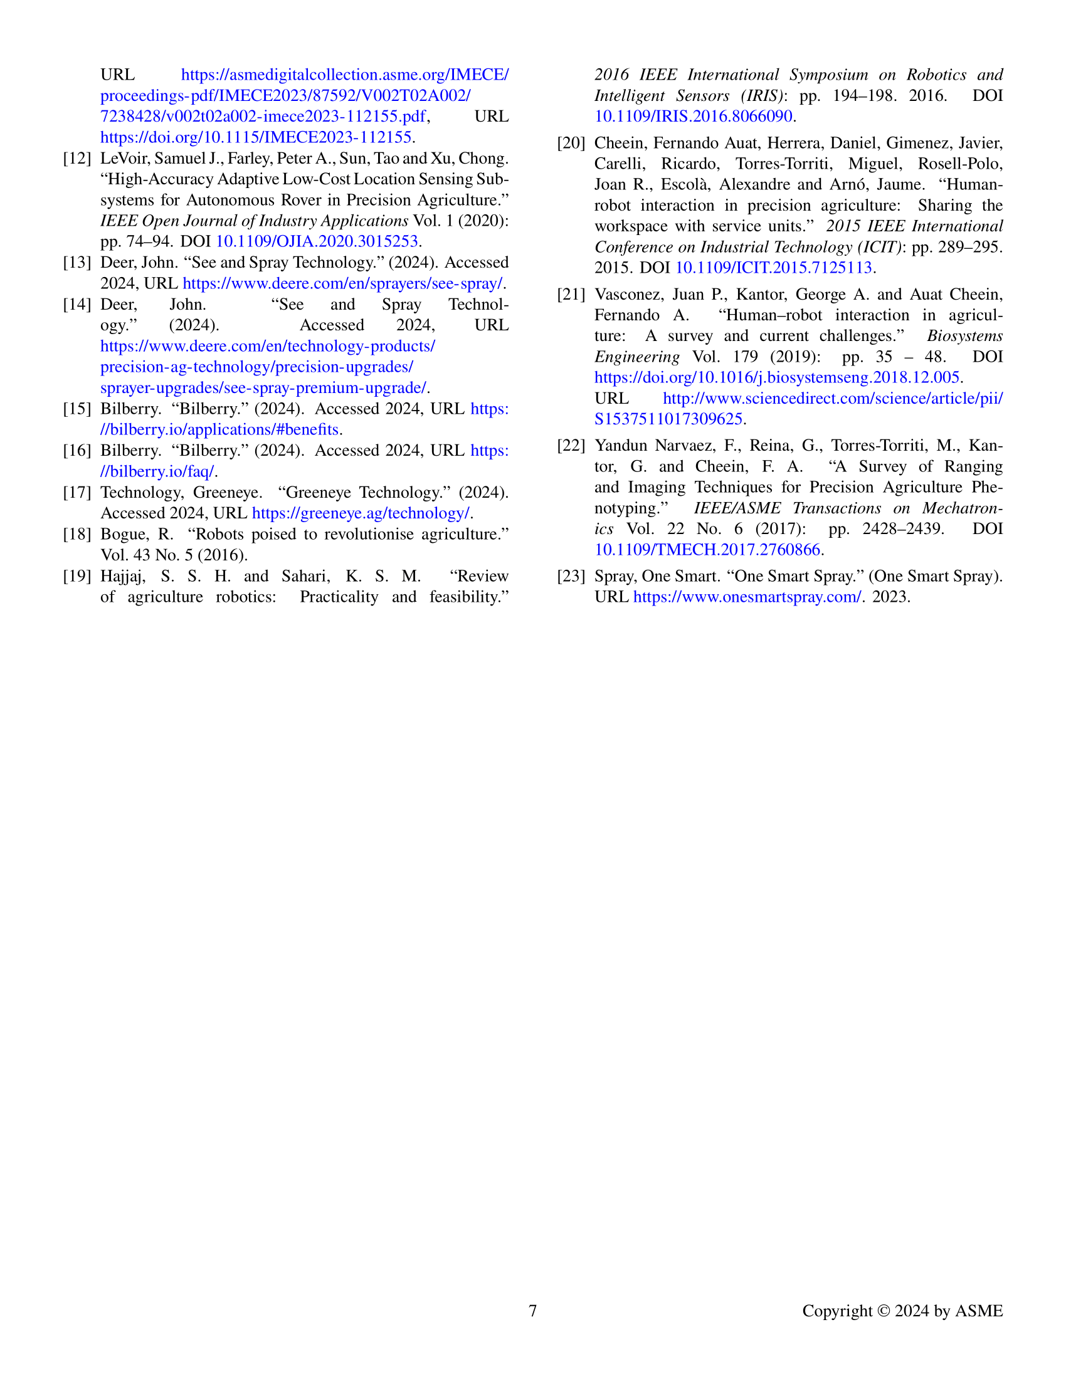
[picture p19: figure]

Figure A.7
