irahulone/sprayer_system/(list of files, cad)

Other CAD files:
v3_amy/cad/sprayer system module v7.f3d
