irahulone/sprayer_system/prescription_model/gps_config.cfg

[Ublox]
port_ids = 0x1546:0x01a9

[Robot]
name = Agbot_II

[Gps]
gps_topic = gps
agg_topic = gps_agg
heading_topic = heading
left = 1-1.3
right = 1-1.4
coords_hz = 10
dop_hz = 2
sync_skew_ms = 75
heading_window = 5
speed_window = 5
pos_filter_enabled = true
pos_window = 5    


[Node]
name = diff_gps
queue_length = 5
gps_timer_period = 0.05
gps = True
diff = True
heading = True
