irahulone/sprayer_system/prescription_model/gps_nav.cfg

[Robot]
name = Kanda
cmd_name = cmd_vel

[Arduino]
port = /dev/ttyACM0

[Nav]
speed_enabled = True
speed_fallback = 5
start_lat = 37.34923655
start_lon = -121.93795589999999
target_lat = 37.3493108
target_lon = -121.9379983
target_speed = 0.5
max_speed = 1
max_cmd = 0.5
gps_filter = 0.4
speed_filter = 0.3
bearing_filter = 0.4
path_name = paths/test_2.json
z_max = 5

[Gains]
linear_p = 0.7
linear_i = 0.05
angular = 0.5
cross_track = 0.2

[Tolerance]
distance = 0.5
angle = 10

[Gps]
gps_topic = gps
agg_topic = gps_agg
heading_topic = heading
[Node]
name = gps_nav
queue_length = 5
timer = 0.05
