irahulone/sprayer_system/prescription_model/src/diff_gps/diff_gps/ublox_gps.py

# Python library for the SparkFun's line of u-Blox GPS units.
#
# SparkFun GPS-RTK NEO-M8P:
#   https://www.sparkfun.com/products/15005
# SparkFun GPS-RTK2 ZED-F9P:
#   https://www.sparkfun.com/products/15136
# SparkFun GPS ZOE-M8Q:
#   https://www.sparkfun.com/products/15193
# SparkFun GPS SAM-M8Q:
#   https://www.sparkfun.com/products/15210
# SparkFun GPS-RTK Dead Reckoning Phat ZED-F9R:
#   https://www.sparkfun.com/products/16475
# SparkFun GPS-RTK Dead Reckoning ZED-F9R:  
#   https://www.sparkfun.com/products/16344
# SparkFun GPS Dead Reckoning NEO-M9N:
#   https://www.sparkfun.com/products/15712
#
#------------------------------------------------------------------------
# Written by SparkFun Electronics, July 2020
#
# Do you like this library? Help suphard_port SparkFun. Buy a board!
#==================================================================================
# GNU GPL License 3.0
# Copyright (c) 2020 SparkFun Electronics
# 
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
# The following code is a dependent on work by daymople and the awesome parsing
# capabilities of ubxtranslator: https://github.com/dalymople/ubxtranslator.
#
# pylint: disable=line-too-long, bad-whitespace, invalid-name, too-many-public-methods
#

import struct
import serial
import spidev

import threading
import time

import collections

import sys
import traceback

from . import sfeSpiWrapper
from . import sparkfun_predefines as sp
from . import core

_DEFAULT_NAME = "Qwiic GPS"
_AVAILABLE_I2C_ADDRESS = [0x42]

class UbloxGps(object):
    """
    UbloxGps

    Initialize the library with the given port.

    :param hard_port:   The port to use to communicate with the module, this
                        can be a serial or SPI port. If no port is given, then the library
                        assumes serial at a 38400 baud rate.

    :return:            The UbloxGps object.
    :rtype:             Object
    """
    MAX_NMEA_LINES = 50
    MAX_ERRORS = 5



    device_name = _DEFAULT_NAME
    available_addresses = _AVAILABLE_I2C_ADDRESS

    def __init__(self, hard_port = None):
        if hard_port is None:
            self.hard_port = serial.Serial("/dev/serial0/", 38400, timeout=1)
        elif type(hard_port) == spidev.SpiDev:
            sfeSpi = sfeSpiWrapper(hard_port)
            self.hard_port = sfeSpi
        else:
            self.hard_port = hard_port

        self.nmea_line_buffer = collections.deque(maxlen=UbloxGps.MAX_NMEA_LINES)

        self.worker_exception_buffer = collections.deque(maxlen=UbloxGps.MAX_ERRORS)
        self.pckt_scl = {
            'lon' : (10**-7),
            'lat' :  (10**-7),
            'headMot' :  (10**-5),
            'headAcc' :  (10**-5),

            'pDOP' :  0.01,
            'gDOP' : 0.01,
            'tDOP' : 0.01,
            'vDOP' : 0.01,
            'hDOP' : 0.01,
            'nDOP' : 0.01,
            'eDOP' : 0.01,

            'headVeh' : (10**-5),
            'magDec' : (10**-2),
            'magAcc' : (10**-2),

            'lonHp' : (10**-9),
            'latHp' : (10**-9),
            'heightHp' : 0.1,
            'hMSLHp' : 0.1,
            'hAcc' : 0.1,
            'vAcc' : 0.1,

            'errEllipseOrient': (10**-2),

            'ecefX' : 0.1,
            'ecefY' : 0.1,
            'ecefZ' : 0.1,
            'pAcc' : 0.1,

            'prRes' : 0.1,

            'cAcc' : (10**-5),
            'heading' : (10**-5),

            'relPosHeading' : (10**-5),
            'relPosHPN' : 0.1,
            'relPosHPE' : 0.1,
            'relPosHPD' : 0.1,
            'relPosHPLength' : 0.1,
            'accN' : 0.1,
            'accE' : 0.1,
            'accD' : 0.1,
            'accLength' : 0.1,
            'accPitch' : (10**-5),
            'accHeading' : (10**-5),

            'roll' : (10**-5),
            'pitch' : (10**-5),
        }

        #packet storage
        self.packets = {}
        # Class message values
        self.cls_ms = {}
        #class message list for auto-update
        self.cls_ms_auto = {}

        tmp_all_cls = []

        for (k,v) in vars(sp).items():
            if isinstance(v, core.Cls):
                tmp_all_cls.append(v)
                self.packets[v.name] = {}
                self.cls_ms_auto[v.name] = []
                self.cls_ms[v.name] = (v.id_, {})

                for (mk, mv) in v._messages.items():
                    self.cls_ms[v.name][1][mv.name] = mk

        self.parse_tool = core.Parser(tmp_all_cls)

        self.stopping = False

        self.thread = threading.Thread(target=self.run_packet_reader, args=())
        self.thread.daemon = True
        self.thread.start()


    def set_packet(self, cls_name, msg_name, payload):
        """
        Creates a new packet with the given class and message name. 
        """
        if (payload is None):
            if msg_name in self.packets[cls_name]:
                del self.packets[cls_name][msg_name]
        else:
            self.packets[cls_name][msg_name] = payload

    def wait_packet(self, cls_name, msg_name, wait_time):
        """
        Parses messages for the given class and message as long as the given time is not 
        exceeeded.
        :return: ublox message
        :rtype: namedtuple
        """
        if wait_time < 0 or wait_time is None:
            wait_time = 0

        orig_tm = time.monotonic()

        while (msg_name not in self.packets[cls_name]):
            time.sleep(0.05)

            if ((time.monotonic() - orig_tm) >= wait_time / 1000.0 ):
                break

        return self.packets[cls_name][msg_name] if msg_name in self.packets[cls_name] else None

    def run_packet_reader(self):
        c2 = bytes()

        while True:
            try:
                if (self.stopping):
                    break

                c2 = c2 + self.hard_port.read(1)
                c2 = c2[-len(core.Parser.PREFIX):]  # keep just 2 bytes, dump the rest

                #if (c2[-1:] == b'$'):
                    #nmea_data = core.Parser._read_until(self.hard_port, b'\x0d\x0a')
                    #try:
                        #self.nmea_line_buffer.append('$' + nmea_data.decode('utf-8').rstrip(' \r\n'))
                    #except:
                        #pass  # ignore bad messages
                    #c2 = b''

                if (c2 == core.Parser.PREFIX):
                    cls_name, msg_name, payload = self.parse_tool.receive_from(self.hard_port, True, True)
                    if not (cls_name is None or msg_name is None or payload is None):
                        self.set_packet(cls_name, msg_name, payload)

                if (self.stopping):
                    break


            except:  # catch *all* exceptions
                self.worker_exception_buffer.append(sys.exc_info())
                if (self.stopping):
                    break


    
    def stop(self):
        self.stopping = True
        self.thread.join()

    def __enter__(self):
        return self

    def __exit__(self, type, value, tb):
        self.stop()

    def send_message(self, cls_name, msg_name, ubx_payload = None):
        """
        Sends a ublox message to the ublox module.

        :param cls_name:   The ublox class with which to send or receive the
                            message to/from.
        :param msg_name:      The message name under the ublox class with which
                            to send or receive the message to/from.
        :param ubx_payload: The payload to send to the class/id specified. If
                            none is given than a "poll request" is
                            initiated.
        :return: True on completion
        :rtype: boolean
        """

        ubx_class_id = self.cls_ms[cls_name][0] #convert names to ids
        ubx_id = self.cls_ms[cls_name][1][msg_name]

        SYNC_CHAR1 = 0xB5
        SYNC_CHAR2 = 0x62

        if ubx_payload == b'\x00':
            ubx_payload = None

        if ubx_payload is None:
            payload_length = 0
        elif isinstance(ubx_payload, list):
            ubx_payload = bytes(ubx_payload)
            payload_length = len(ubx_payload)
        elif not(isinstance(ubx_payload, bytes)):
            ubx_payload = bytes([ubx_payload])
            payload_length = len(ubx_payload)
        else:
            payload_length = len(ubx_payload)


        message = bytes((SYNC_CHAR1, SYNC_CHAR2,
                      ubx_class_id, ubx_id, (payload_length & 0xFF),
                      (payload_length >> 8)))

        if payload_length > 0:
             message = message + ubx_payload

        checksum = core.Parser._generate_fletcher_checksum(message[2:])

        self.hard_port.write(message + checksum)

        return True

    def request_standard_packet(self, cls_name, msg_name, ubx_payload=None, wait_time=2500, rethrow_thread_exception=True):
        prev = self.packets.get(cls_name, {}).get(msg_name)
    
        # If not auto, clear and poll
        if not (msg_name in self.cls_ms_auto[cls_name] and ubx_payload is None):
            self.set_packet(cls_name, msg_name, None)
            self.send_message(cls_name, msg_name, ubx_payload)
    
        start = time.monotonic()
        while True:
            pkt = self.packets.get(cls_name, {}).get(msg_name)
            if pkt is not None:
                if (prev is None) or (getattr(pkt, "iTOW", None) != getattr(prev, "iTOW", None)):
                    break  # got a fresh one
            if (time.monotonic() - start) >= (wait_time / 1000.0):
                break
            time.sleep(0.005)
    
        if len(self.worker_exception_buffer) > 0:
            err = self.worker_exception_buffer.popleft()
            raise err[1].with_traceback(err[2])
    
        return self.scale_packet(pkt) if pkt is not None else None


    def scale_packet(self, packet):
        """
        Scales the given packet to the unit specified in the interface manual.
        :return: ublox payload
        :rtype: packet
        """
        dict_packet = packet._asdict()
        isdirty = False
        for (k,v) in dict_packet.items():
            if k in self.pckt_scl:
                isdirty = True
                dict_packet[k] = self.pckt_scl[k] * v

        return type(packet)(**dict_packet) if isdirty else packet #we only need to reallocate and rebuild packet if it was changed


    def stream_nmea(self, wait_for_nmea = True):
        """
        Checks NMEA buffer for new messages and passes them back to the user 
        when detected. 
        :return: nmea message
        :rtype: string
        """
        while wait_for_nmea and len(self.nmea_line_buffer) == 0:
            time.sleep(0.05)

        return self.nmea_line_buffer.popleft() if len(self.nmea_line_buffer) > 0 else None

    def ubx_get_val(self, key_id, layer = 0, wait_time = 2500):
        """
        This function takes the given key id and breakes it into individual bytes
        which are then cocantenated together. This payload is then sent along
        with the CFG Class and VALGET Message ID to send_message(). Ublox
        Messages are then parsed for the requested values or a NAK signifying a
        problem.
        :return: The requested payload or a NAK on failure.
        :rtype: namedtuple
        """

        # layer 0 (RAM) and layer 7 (Default)! are the only options
        if layer != 7:
            layer = 0

        payloadCfg = [0,layer,0,0,
            (key_id) & 255,
            (key_id >> 8) & 255,
            (key_id >> 16) & 255,
            (key_id >> 24) & 255
        ]

        return self.request_standard_packet('CFG', 'VALGET', bytes(payloadCfg), wait_time = wait_time) #we return result immediately, hope get_val request won't overlap

    def ubx_set_val(self, key_id, ubx_payload, layer = 7, wait_time = 2500):
        """
        This function takes the given key id and breakes it into individual bytes
        which are then cocantenated together. This payload is then sent along
        with the CFG Class and VALSET Message ID to send_message(). Ublox
        Messages are then parsed for the requested values or a NAK signifying a
        problem.
        :return: None
        :rtype: namedtuple
        """


        if ubx_payload is None:
            return
        elif isinstance(ubx_payload, list):
            ubx_payload = bytes(ubx_payload)
        elif not(isinstance(ubx_payload, bytes)):
            ubx_payload = bytes([ubx_payload])

        if len(ubx_payload) == 0:
            return


        payloadCfg = [0,layer,0,0,
            (key_id) & 255,
            (key_id >> 8) & 255,
            (key_id >> 16) & 255,
            (key_id >> 24) & 255
        ]

        self.request_standard_packet('CFG', 'VALSET', bytes(payloadCfg) + ubx_payload, wait_time = wait_time)

    def set_auto_msg(self, cls_name, msg_name, freq, wait_time = 2500):
        ubx_class_id = self.cls_ms[cls_name][0] #convert names to ids
        ubx_id = self.cls_ms[cls_name][1][msg_name]

        if freq is None:
            freq = 0
        elif isinstance(freq, bool):
            freq = 1 if freq else 0
        elif freq < 0:
            freq = 0

        if msg_name in self.cls_ms_auto[cls_name]:
            self.cls_ms_auto[cls_name].remove(msg_name)

        if freq > 0:
            self.cls_ms_auto[cls_name].append(msg_name)

        payloadCfg = [ubx_class_id, ubx_id, freq]

        self.request_standard_packet('CFG', 'MSG', payloadCfg, wait_time = wait_time)

    def geo_coords(self, wait_time = 2500):
        """
-       Sends a poll request for NAV class and the PVT Message 
+       The response is then passed on to the user.

        :return: ublox payload
        :rtype: namedtuple
        """
        return self.request_standard_packet('NAV', 'PVT', wait_time = wait_time)

    def get_DOP(self, wait_time = 2500):
        """
-       Sends a poll request for NAV class and the DOP Message 
+       The response is then passed on to the user.

        :return: ublox payload
        :rtype: namedtuple
        """
        return self.request_standard_packet('NAV', 'DOP', wait_time = wait_time)

    def geo_cov(self, wait_time = 2500):
        """
-       Sends a poll request for NAV class and the COV Message 
+       The response is then passed on to the user.

        :return: ublox payload
        :rtype: namedtuple
        """
        return self.request_standard_packet('NAV', 'COV', wait_time = wait_time)

    def hp_geo_coords(self, wait_time = 2500):
        """
-       Sends a poll request for NAV class and the HPPOSLLH Message 
+       The response is then passed on to the user.

        :return: ublox payload
        :rtype: namedtuple
        """
        return self.request_standard_packet('NAV', 'HPPOSLLH', wait_time = wait_time)

    def date_time(self, wait_time = 2500):
        """
-       Sends a poll request for NAV class and the HPPOSLLH Message 
+       The response is then passed on to the user.

        :return: ublox payload
        :rtype: namedtuple
        """
        return self.request_standard_packet('NAV', 'PVT', wait_time = wait_time)

    def satellites(self, wait_time = 2500):
        """
-       Sends a poll request for NAV class and the SAT Message 
+       The response is then passed on to the user.

        :return: ublox payload
        :rtype: namedtuple
        """
        return self.request_standard_packet('NAV', 'SAT', wait_time = wait_time)

    def veh_attitude(self, wait_time = 2500):
        """
-       Sends a poll request for NAV class and the ATT Message 
+       The response is then passed on to the user.

        :return: ublox payload
        :rtype: namedtuple
        """
        return self.request_standard_packet('NAV', 'ATT', wait_time = wait_time)

    def imu_alignment(self, wait_time = 2500):
        """
-       Sends a poll request for ESF class and the ALG Message 
+       The response is then passed on to the user.

        :return: ublox payload
        :rtype: namedtuple
        """
        return self.request_standard_packet('ESF', 'ALG', wait_time = wait_time)

    def vehicle_dynamics(self, wait_time = 2500):
        """
-       Sends a poll request for ESF class and the INS Message 
+       The response is then passed on to the user.

        :return: ublox payload
        :rtype: namedtuple
        """
        return self.request_standard_packet('ESF', 'INS', wait_time = wait_time)

    def esf_measures(self, wait_time = 2500):
        """
-       Sends a poll request for ESF class and the MEAS Message 
+       The response is then passed on to the user.

        :return: ublox payload
        :rtype: namedtuple
        """
        return self.request_standard_packet('ESF', 'MEAS', wait_time = wait_time)

    def esf_raw_measures(self, wait_time = 2500):
        """
-       Sends a poll request for ESF class and the RAW Message 
+       The response is then passed on to the user.

        :return: ublox payload
        :rtype: namedtuple
        """
        return self.request_standard_packet('ESF', 'RAW', wait_time = wait_time)

    def reset_imu_align(self, wait_time = 2500):
        """
-       Sends a poll request for ESF class and the RESETALG Message 
+       The response is then passed on to the user.

        :return: ublox payload
        :rtype: namedtuple
        """
        return self.request_standard_packet('ESF', 'RESETALG', wait_time = wait_time)

    def esf_status(self, wait_time = 2500):
        """
-       Sends a poll request for ESF class and the RESETALG Message 
+       The response is then passed on to the user.

        :return: ublox payload
        :rtype: namedtuple
        """
        return self.request_standard_packet('ESF', 'STATUS', wait_time = wait_time)

    def port_settings(self, wait_time = 2500):
        """
-       Sends a poll request for ESF class and the COMMS Message 
+       The response is then passed on to the user.

        :return: ublox payload
        :rtype: namedtuple
        """
        return self.request_standard_packet('MON', 'COMMS', wait_time = wait_time)

    def module_gnss_support(self, wait_time = 2500):
        """
-       Sends a poll request for MON class and the GNSS Message 
+       The response is then passed on to the user.

        :return: ublox payload
        :rtype: namedtuple
        """
        return self.request_standard_packet('MON', 'GNSS', wait_time = wait_time)

    def pin_settings(self, wait_time = 2500):
        """
-       Sends a poll request for MON class and the HW2 Message 
+       The response is then passed on to the user.

        :return: ublox payload
        :rtype: namedtuple
        """
        return self.request_standard_packet('MON', 'HW3', wait_time = wait_time)

    def installed_patches(self, wait_time = 2500):
        """
-       Sends a poll request for MON class and the PATCH Message 
+       The response is then passed on to the user.

        :return: ublox payload
        :rtype: namedtuple
        """
        return self.request_standard_packet('MON', 'PATCH', wait_time = wait_time) #changed from HW3 to PATCH

    def prod_test_pio(self, wait_time = 2500):
        """
-       Sends a poll request for MON class and the PIO Message 
+       The response is then passed on to the user.

        :return: ublox payload
        :rtype: namedtuple
        """
        return self.request_standard_packet('MON', 'PIO', wait_time = wait_time)

    def prod_test_monitor(self, wait_time = 2500):
        """
-       Sends a poll request for MON class and the PT2 Message 
+       The response is then passed on to the user.

        :return: ublox payload
        :rtype: namedtuple
        """
        return self.request_standard_packet('MON', 'PT2', wait_time = wait_time)

    def rf_ant_status(self, wait_time = 2500):
        """
-       Sends a poll request for MON class and the RF Message 
+       The response is then passed on to the user.

        :return: ublox payload
        :rtype: namedtuple
        """
        return self.request_standard_packet('MON', 'RF', wait_time = wait_time)

    def module_wake_state(self, wait_time = 2500): #No response on F9P
        """
-       Sends a poll request for MON class and the RXR Message 
+       The response is then passed on to the user.

        :return: ublox payload
        :rtype: namedtuple
        """
        return self.request_standard_packet('MON', 'RXR', wait_time = wait_time)

    def sensor_production_test(self, wait_time = 2500):#No response on F9P
        """
-       Sends a poll request for MON class and the SPT Message 
+       The response is then passed on to the user.

        :return: ublox payload
        :rtype: namedtuple
        """
        return self.request_standard_packet('MON', 'SPT', wait_time = wait_time)

    def module_software_version(self, wait_time = 2500):
        """
-       Sends a poll request for MON class and the VER Message 
+       The response is then passed on to the user.

        :return: ublox payload
        :rtype: namedtuple
        """
        return self.request_standard_packet('MON', 'VER', wait_time = wait_time)
