irahulone/sprayer_system/(commit log)

2025-09-09 Rename v3_amy/flow3_lookup_banked.h to v3_amy/arduino/lookup tables/flow3_lookup_banked.h
2025-09-09 Rename v3_amy/arduino/flow2_lookup_banked.h to v3_amy/arduino/lookup tables/flow2_lookup_banked.h
2025-09-09 Rename v3_amy/flow4_lookup_banked.h to v3_amy/arduino/lookup tables/flow4_lookup_banked.h
2025-09-09 Rename v3_amy/sprayer system module v7.f3d to v3_amy/cad/sprayer system module v7.f3d
    [sprayer system module v7.f3d]
