irahulone/sprayer_system/(notices)

Notices in the files:
prescription_model/src/diff_gps/diff_gps/ublox_gps.py:
This program is free software: you can redistribute it and/or modify
it under the terms of the GNU General Public License as published by
the Free Software Foundation, either version 3 of the License, or
(at your option) any later version.
